fdreshaj/ESP32-Scan-Position-Monitor/README.md

Work in Progress, RF branch for RF. Will be updating with new design
