fdreshaj/ESP32-Scan-Position-Monitor/ESP_32_sens.kicad_pcb

## KiCad design ESP_32_sens.kicad_pcb (2025-09-08)

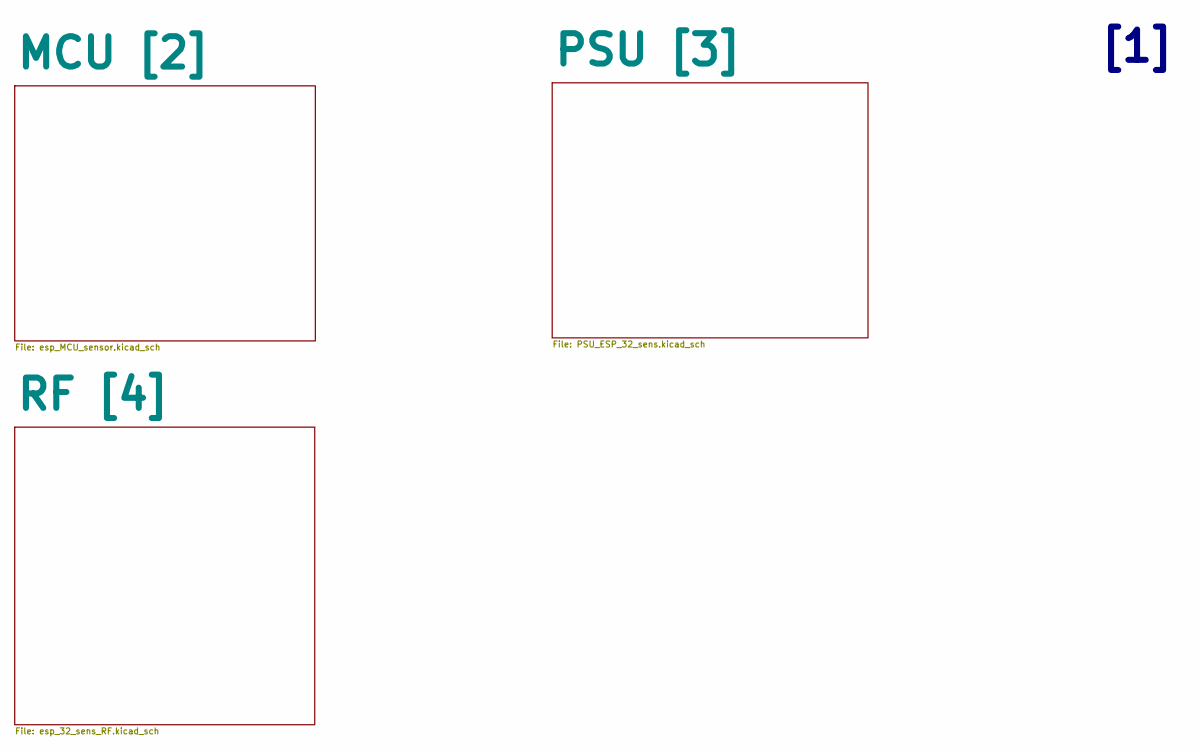
[picture p1: schematic ESP_32_sens.kicad_sch, Motion_Tracker_V0]

Notes on the sheet:
[1]

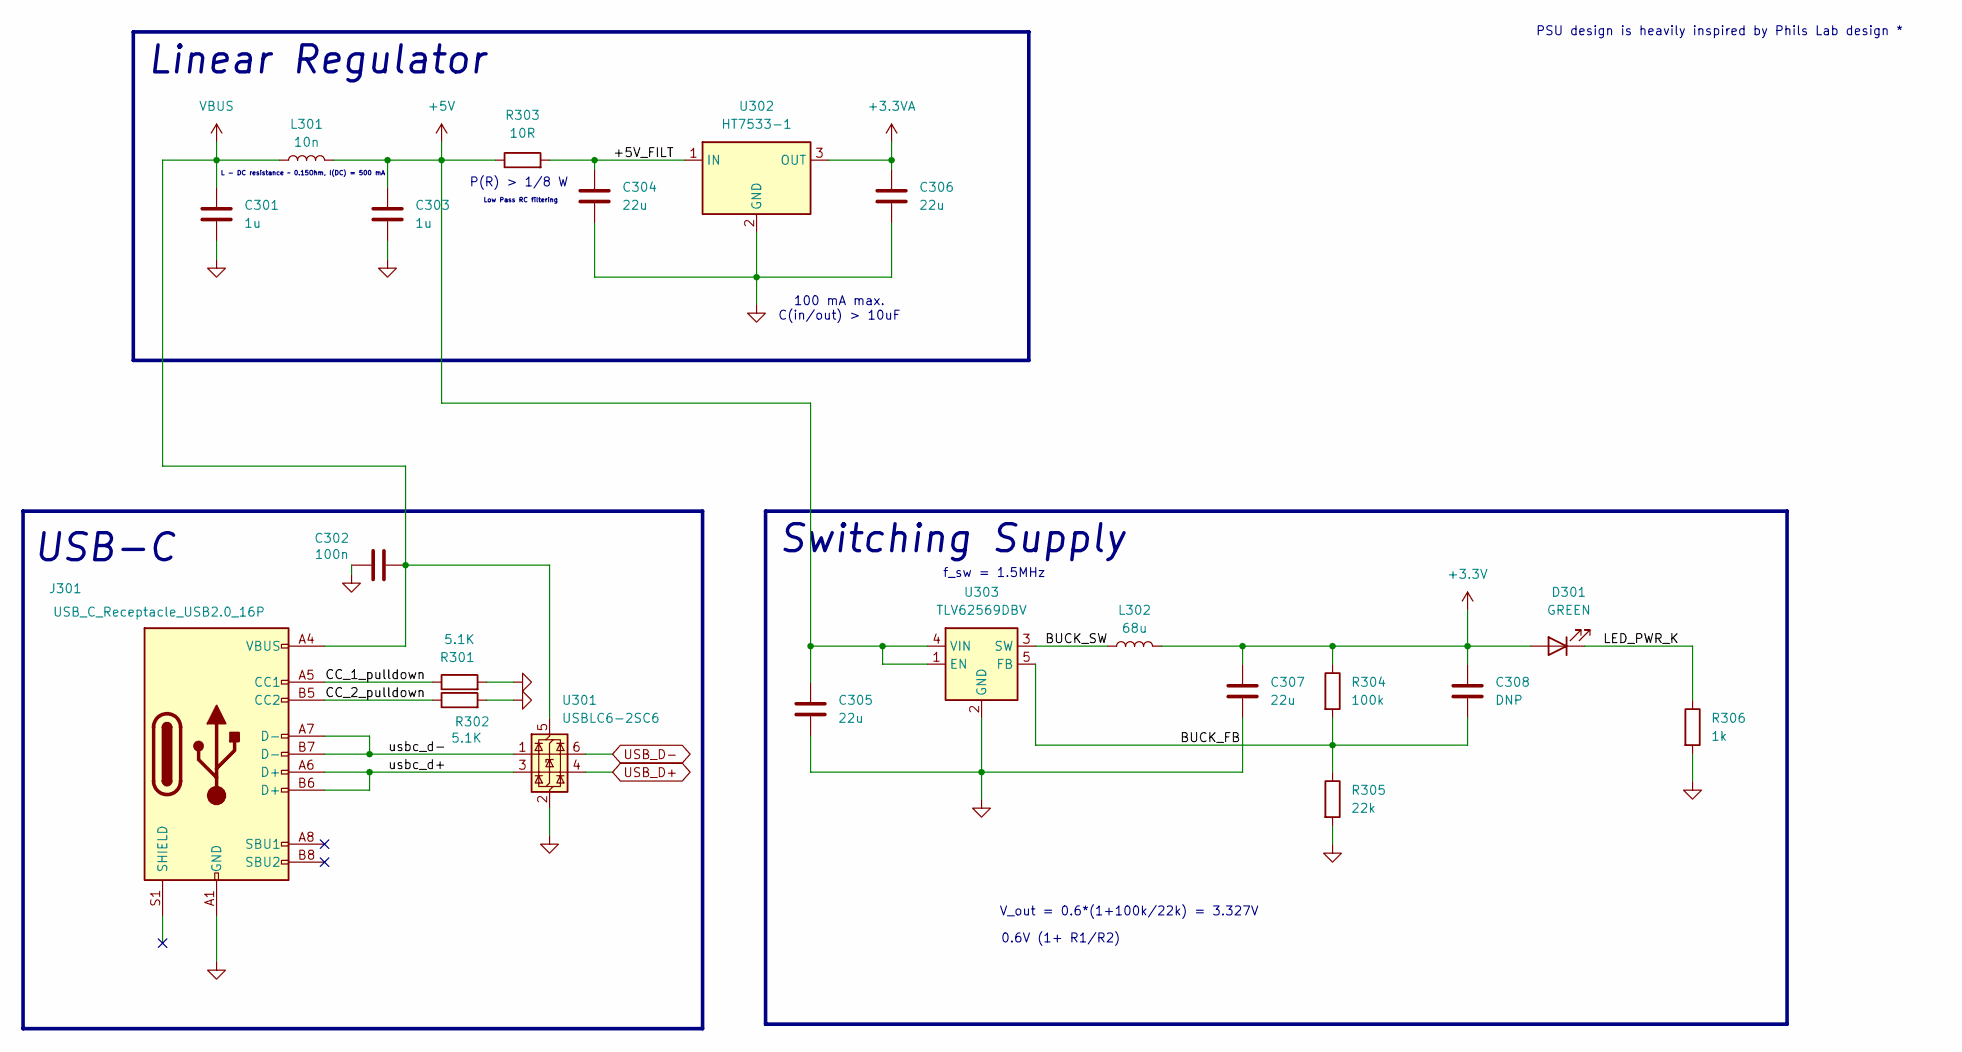
[picture p2: schematic PSU_ESP_32_sens.kicad_sch, Motion_Tracker_V0]

Parts:
C301, C303: 1u; C_0603_1608Metric_Pad1.08x0.95mm_HandSolder
C302: 100n; C_0402_1005Metric_Pad0.74x0.62mm_HandSolder
C304, C305, C306, C307: 22u; C_0603_1608Metric_Pad1.08x0.95mm_HandSolder
C308: DNP; C_0402_1005Metric_Pad0.74x0.62mm_HandSolder
D301: GREEN; LED_0402_1005Metric_Pad0.77x0.64mm_HandSolder
J301: USB_C_Receptacle_USB2.0_16P; USB_C_Receptacle_G-Switch_GT-USB-7010ASV
L301: 10n; L_0402_1005Metric_Pad0.77x0.64mm_HandSolder
L302: 68u; L_0603_1608Metric_Pad1.05x0.95mm_HandSolder
R301, R302: 5.1K; R_0402_1005Metric_Pad0.72x0.64mm_HandSolder
R303: 10R; R_0402_1005Metric_Pad0.72x0.64mm_HandSolder
R304: 100k; R_0402_1005Metric_Pad0.72x0.64mm_HandSolder
R305: 22k; R_0402_1005Metric_Pad0.72x0.64mm_HandSolder
R306: 1k; R_0402_1005Metric_Pad0.72x0.64mm_HandSolder
U301: USBLC6-2SC6; SOT-23-6
U302: HT7533-1; SOT-223-3_TabPin2
U303: TLV62569DBV; SOT-23-5

Connections:
+3.3V: C307.1, C308.1, D301.2 (A), L302.2, R304.1; also elsewhere on the board
+3.3VA: C306.1, U302.3 (OUT); also elsewhere on the board
+5V: C303.1, C305.1, L301.2, R303.1, U303.1 (EN), U303.4 (VIN)
/PSU [3]/+5V_FILT: C304.1, R303.2, U302.1 (IN)
/PSU [3]/BUCK_FB: C308.2, R304.2, R305.1, U303.5 (FB)
/PSU [3]/BUCK_SW: L302.1, U303.3 (SW)
/PSU [3]/CC_1_pulldown: J301.A5 (CC1), R301.1
/PSU [3]/CC_2_pulldown: J301.B5 (CC2), R302.1
/PSU [3]/LED_PWR_K: D301.1 (K), R306.1
/PSU [3]/usbc_d+: J301.A6 (D+), J301.B6 (D+), U301.3 (I/O2)
/PSU [3]/usbc_d-: J301.A7 (D-), J301.B7 (D-), U301.1 (I/O1)
GND: C301.2, C302.1, C303.2, C304.2, C305.2, C306.2, C307.2, J301.A1 (GND), J301.A12 (GND), J301.B1 (GND), J301.B12 (GND), R301.2, R302.2, R305.2, R306.2, U301.2 (GND), U302.2 (GND), U303.2 (GND); also elsewhere on the board
USB_D+: U301.4 (I/O2); also elsewhere on the board
USB_D-: U301.6 (I/O1); also elsewhere on the board
VBUS: C301.1, C302.2, J301.A4 (VBUS), J301.A9 (VBUS), J301.B4 (VBUS), J301.B9 (VBUS), L301.1, U301.5 (VBUS)

Notes on the sheet:
USB-C
Linear Regulator
V_out = 0.6*(1+100k/22k) = 3.327V
Low Pass RC filtering
0.6V (1+ R1/R2)
f_sw = 1.5MHz
Switching Supply
L - DC resistance ~ 0.15Ohm, I(DC) = 500 mA
P(R) > 1/8 W
100 mA max. C(in/out) > 10uF
PSU design is heavily inspired by Phils Lab design *

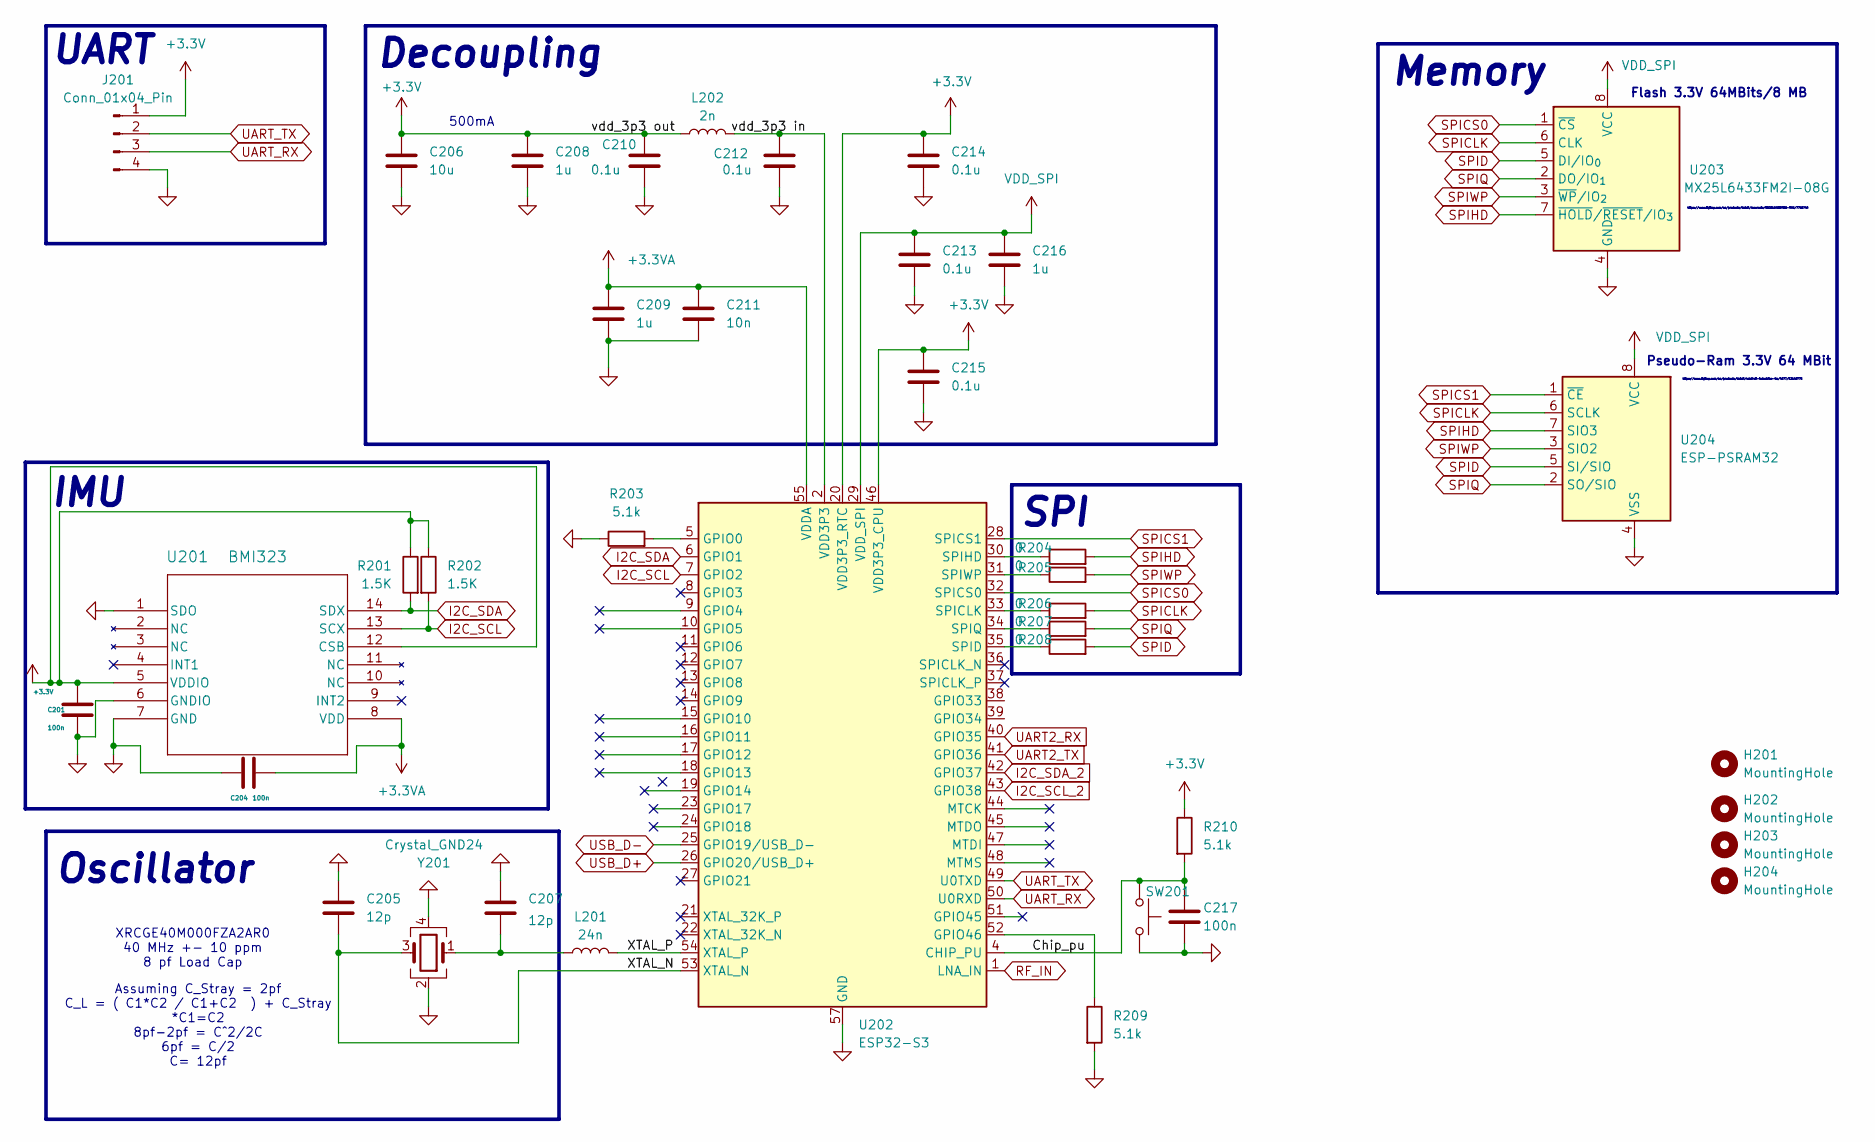
[picture p3: schematic esp_MCU_sensor.kicad_sch, Motion_Tracker_V1]

Parts:
C201, C204, C217: 100n; C_0402_1005Metric_Pad0.74x0.62mm_HandSolder
C205, C207: 12p; C_0402_1005Metric_Pad0.74x0.62mm_HandSolder
C206: 10u; C_0603_1608Metric_Pad1.08x0.95mm_HandSolder
C208, C209, C216: 1u; C_0603_1608Metric_Pad1.08x0.95mm_HandSolder
C210, C212, C213, C214, C215: 0.1u; C_0402_1005Metric_Pad0.74x0.62mm_HandSolder
C211: 10n; C_0402_1005Metric_Pad0.74x0.62mm_HandSolder
H201, H202, H203, H204: MountingHole; MountingHole_3.2mm_M3
J201: Conn_01x04_Pin; Wuerth_WR-WTB_64800411622_1x04_P1.50mm_Vertical
L201: 24n; L_0402_1005Metric_Pad0.77x0.64mm_HandSolder
L202: 2n; L_0402_1005Metric_Pad0.77x0.64mm_HandSolder
R201, R202: 1.5K; R_0402_1005Metric_Pad0.72x0.64mm_HandSolder
R203, R209, R210: 5.1k; R_0402_1005Metric_Pad0.72x0.64mm_HandSolder
R204, R205, R206, R207, R208: 0; R_0402_1005Metric_Pad0.72x0.64mm_HandSolder
SW201: SW_Push; SW_PUSH_6mm_H4.3mm
U201: BMI323; BMI323_BOS
U202: ESP32-S3; QFN-56-1EP_7x7mm_P0.4mm_EP4x4mm
U203: MX25L6433FM2I-08G; SOIC-8_5.3x5.3mm_P1.27mm
U204: ESP-PSRAM32; SOIC-8_3.9x4.9mm_P1.27mm
Y201: Crystal_GND24; Crystal_SMD_SeikoEpson_FA128-4Pin_2.0x1.6mm

Connections:
+3.3V: C201.1, C206.2, C208.2, C210.2, C214.1, C215.1, J201.1, L202.1, R201.1, R202.1, R210.1, U201.5 (VDDIO), U201.12 (CSB), U202.20 (VDD3P3_RTC), U202.46 (VDD3P3_CPU); also elsewhere on the board
+3.3VA: C204.2, C209.1, C211.1, U201.8 (VDD), U202.55 (VDDA), U202.56 (VDDA); also elsewhere on the board
/MCU [2]/Chip_pu: C217.1, R210.2, SW201.1, U202.4 (CHIP_PU)
/MCU [2]/XTAL_N: C205.1, U202.53 (XTAL_N), Y201.3
/MCU [2]/XTAL_P: L201.2, U202.54 (XTAL_P)
/MCU [2]/vdd_3p3 in: C212.2, L202.2, U202.2 (VDD3P3), U202.3 (VDD3P3)
GND: C201.2, C204.1, C205.2, C206.1, C207.2, C208.1, C209.2, C210.1, C211.2, C212.1, C213.2, C214.2, C215.2, C216.2, C217.2, J201.4, R203.1, R209.2, SW201.2, U201.1 (SDO), U201.6 (GNDIO), U201.7 (GND), U202.57 (GND), U203.4 (GND), U204.4 (VSS), Y201.2, Y201.4; also elsewhere on the board
I2C_SCL: R202.2, U201.13 (SCX), U202.7 (GPIO2)
I2C_SCL_2: U202.43 (GPIO38); also elsewhere on the board
I2C_SDA: R201.2, U201.14 (SDX), U202.6 (GPIO1)
I2C_SDA_2: U202.42 (GPIO37); also elsewhere on the board
unnamed: C207.1, L201.1, Y201.1
unnamed: R203.2, U202.5 (GPIO0)
unnamed: R209.1, U202.52 (GPIO46)
unnamed: R206.1, U202.33 (SPICLK)
unnamed: R208.1, U202.35 (SPID)
unnamed: R204.1, U202.30 (SPIHD)
unnamed: R207.1, U202.34 (SPIQ)
unnamed: R205.1, U202.31 (SPIWP)
RF_IN: U202.1 (LNA_IN); also elsewhere on the board
SPICLK: R206.2, U203.6 (CLK), U204.6 (SCLK)
SPICS0: U202.32 (SPICS0), U203.1 (~CS)
SPICS1: U202.28 (SPICS1), U204.1 (~CE)
SPID: R208.2, U203.5 (DI/IO_{0}), U204.5 (SI/SIO)
SPIHD: R204.2, U203.7 (~HOLD/~RESET/IO_{3}), U204.7 (SIO3)
SPIQ: R207.2, U203.2 (DO/IO_{1}), U204.2 (SO/SIO)
SPIWP: R205.2, U203.3 (~WP/IO_{2}), U204.3 (SIO2)
UART2_RX: U202.40 (GPIO35); also elsewhere on the board
UART2_TX: U202.41 (GPIO36); also elsewhere on the board
UART_RX: J201.3, U202.50 (U0RXD)
UART_TX: J201.2, U202.49 (U0TXD)
USB_D+: U202.26 (GPIO20/USB_D+); also elsewhere on the board
USB_D-: U202.25 (GPIO19/USB_D-); also elsewhere on the board
VDD_SPI: C213.1, C216.1, U202.29 (VDD_SPI), U203.8 (VCC), U204.8 (VCC)

Notes on the sheet:
SPI
IMU
Memory
Decoupling
UART
XRCGE40M000FZA2AR0 40 MHz +- 10 ppm 8 pf Load Cap
https://www.digikey.com/en/products/detail/adafruit-industries-llc/4677/13148775
Flash 3.3V 64MBits/8 MB
https://www.digikey.com/en/products/detail/macronix/MX25L6433FM2I-08G/7796740
500mA
Assuming C_Stray = 2pf C_L = ( C1*C2 / C1+C2 ) + C_Stray *C1=C2 8pf-2pf = C^2/2C 6pf = C/2 C= 12pf
Pseudo-Ram 3.3V 64 MBit
Oscillator

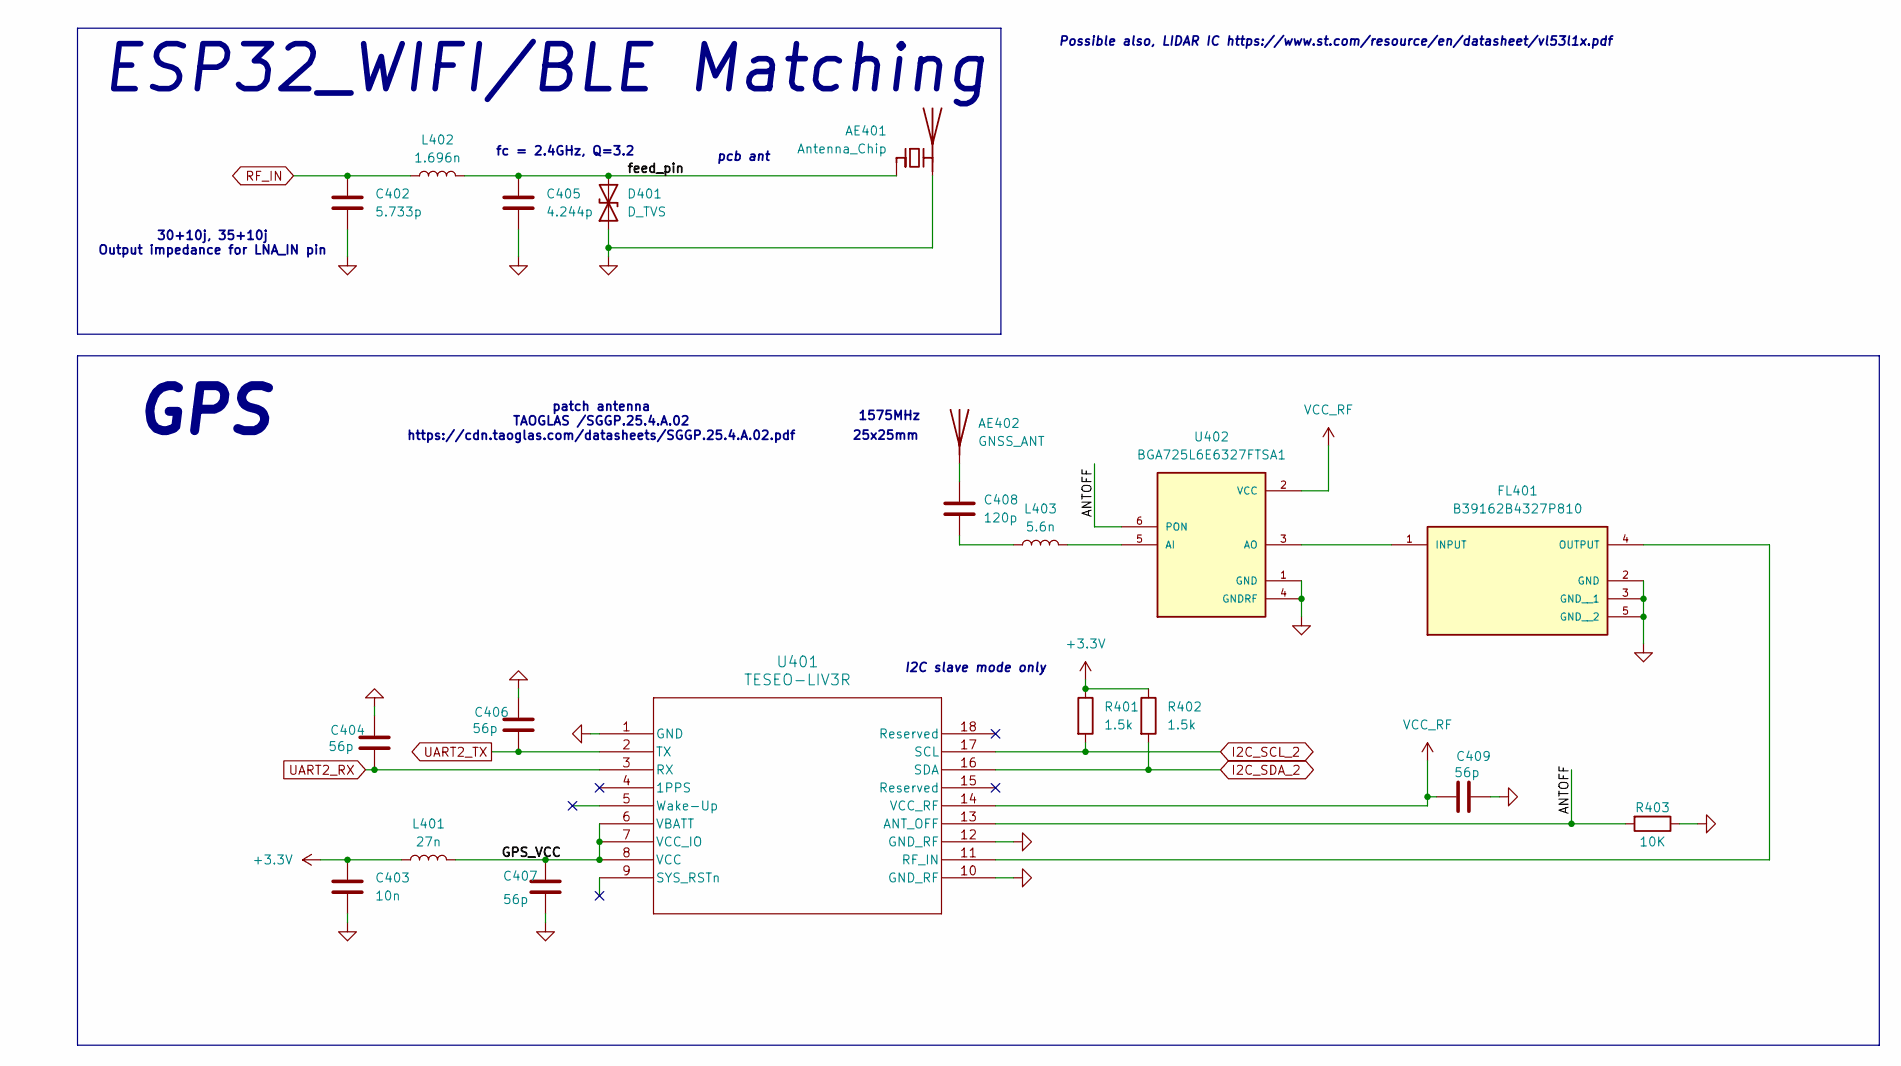
[picture p4: schematic esp_32_sens_RF.kicad_sch]

Parts:
AE401: Antenna_Chip; IFA_2.45_TI
AE402: GNSS_ANT; SGGP.25.4.A.02_TAL
C402: 5.733p; C_0201_0603Metric_Pad0.64x0.40mm_HandSolder
C403: 10n; C_0402_1005Metric_Pad0.74x0.62mm_HandSolder
C404, C406, C407, C409: 56p; C_0402_1005Metric_Pad0.74x0.62mm_HandSolder
C405: 4.244p; C_0201_0603Metric_Pad0.64x0.40mm_HandSolder
C408: 120p; C_0402_1005Metric_Pad0.74x0.62mm_HandSolder
D401: D_TVS; D_0402_1005Metric_Pad0.77x0.64mm_HandSolder
FL401: B39162B4327P810; FIL_B39162B4327P810; PARTREV October 25, 2019
L401: 27n; L_0402_1005Metric_Pad0.77x0.64mm_HandSolder
L402: 1.696n; L_0201_0603Metric_Pad0.64x0.40mm_HandSolder
L403: 5.6n; L_0402_1005Metric_Pad0.77x0.64mm_HandSolder
R401, R402: 1.5k; R_0402_1005Metric_Pad0.72x0.64mm_HandSolder
R403: 10K; R_0402_1005Metric_Pad0.72x0.64mm_HandSolder
U401: TESEO-LIV3R; ARRAY_LIV3R_STM
U402: BGA725L6E6327FTSA1; AMP_BGA725L6E6327FTSA1; PARTREV 2.0

Connections:
+3.3V: C403.1, L401.1, R401.1, R402.1; also elsewhere on the board
/RF [4]/ANTOFF: R403.2, U401.13 (ANT_OFF), U402.6 (PON)
/RF [4]/GPS_VCC: C407.1, L401.2, U401.6 (VBATT), U401.7 (VCC_IO), U401.8 (VCC)
/RF [4]/feed_pin: AE401.1 (FEED), C405.1, D401.2 (A2), L402.2
GND: AE401.2 (PCB_Trace), C402.2, C403.2, C404.1, C405.2, C406.1, C407.2, C409.1, D401.1 (A1), FL401.2 (GND), FL401.3 (GND__1), FL401.5 (GND__2), R403.1, U401.1 (GND), U401.10 (GND_RF), U401.12 (GND_RF), U402.1 (GND), U402.4 (GNDRF); also elsewhere on the board
I2C_SCL_2: R401.2, U401.17 (SCL); also elsewhere on the board
I2C_SDA_2: R402.2, U401.16 (SDA); also elsewhere on the board
unnamed: AE402.1 (A), C408.1
unnamed: C408.2, L403.1
unnamed: FL401.1 (INPUT), U402.3 (AO)
unnamed: FL401.4 (OUTPUT), U401.11 (RF_IN)
unnamed: L403.2, U402.5 (AI)
RF_IN: C402.1, L402.1; also elsewhere on the board
UART2_RX: C404.2, U401.3 (RX); also elsewhere on the board
UART2_TX: C406.2, U401.2 (TX); also elsewhere on the board
VCC_RF: C409.2, U401.14 (VCC_RF), U402.2 (VCC)

Notes on the sheet:
GPS
I2C slave mode only
pcb ant
Possible also, LIDAR IC https://www.st.com/resource/en/datasheet/vl53l1x.pdf
25x25mm
patch antenna TAOGLAS /SGGP.25.4.A.02 https://cdn.taoglas.com/datasheets/SGGP.25.4.A.02.pdf
30+10j, 35+10j Output impedance for LNA_IN pin
ESP32_WIFI/BLE Matching
fc = 2.4GHz, Q=3.2
1575MHz

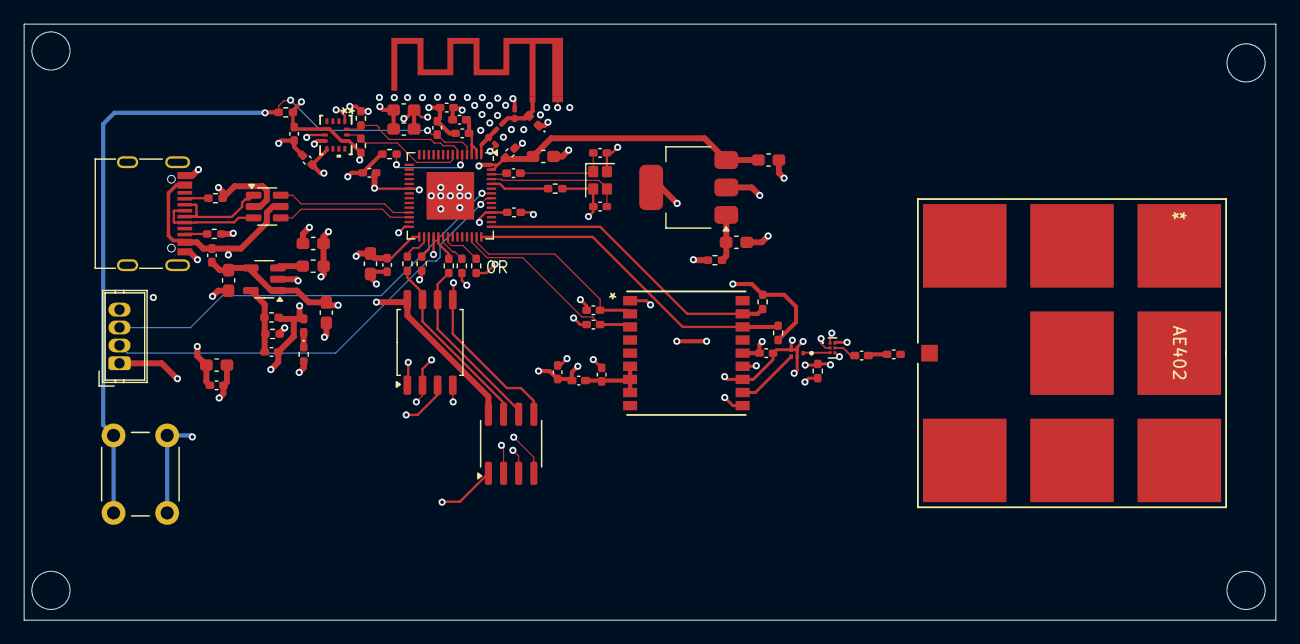
[picture p5: board ESP_32_sens.kicad_pcb from above]

Board: 4 copper layers, 105.0 x 50.0 mm, 79 parts (0 on the bottom side), 53 nets.
