fdreshaj/ESP32-Scan-Position-Monitor/(commit log)

2025-08-14 sent to folder grb
    sent to folder grb
    [ESP_32_sens-B_Cu.gbr, ESP_32_sens-B_Mask.gbr, ESP_32_sens-B_Paste.gbr, ESP_32_sens-B_Silkscreen.gbr, ESP_32_sens-Edge_Cuts.gbr, ESP_32_sens-F_Cu.gbr, ESP_32_sens-F_Mask.gbr, ESP_32_sens-F_Paste.gbr]
2025-08-15 more correct ground plane
    ground plane
    [ESP_32_sens-B_Cu.gbr, ESP_32_sens-B_Mask.gbr, ESP_32_sens-B_Paste.gbr, ESP_32_sens-B_Silkscreen.gbr, ESP_32_sens-Edge_Cuts.gbr, ESP_32_sens-F_Cu.gbr, ESP_32_sens-F_Mask.gbr, ESP_32_sens-F_Paste.gbr]
2025-08-15 additional comment
    additional comment
    [PSU_ESP_32_sens.kicad_sch]
2025-08-18 Add RF schematics for GPS + designed Pi filter for imp matching
    added impedance matching on LNA 1 pin, added GPS/GNSS IC
    [ESP_32_sens.kicad_sch, esp_32_sens_RF.kicad_sch, esp_MCU_sensor.kicad_sch]
2025-08-18 Added antenna design
    added pcb antenna design
    [ESP_32_sens.kicad_pcb, esp_MCU_sensor.kicad_sch]
2025-08-19 placement done
    placement done, routing left
    [ESP_32_sens.kicad_pcb, ESP_32_sens.kicad_sch, PSU_ESP_32_sens.kicad_sch, esp_32_sens_RF.kicad_sch, esp_MCU_sensor.kicad_sch]
2025-08-21 added via stichitching and routing,
    routing mostly done, Only power left
    [ESP_32_sens.kicad_pcb]
2025-08-22 finished power routing
    finished power routing, gps antenna left
    [ESP_32_sens.kicad_pcb, esp_MCU_sensor.kicad_sch]
2025-08-22 minor changes
    minor changes
    [ESP_32_sens.kicad_pcb, esp_MCU_sensor.kicad_sch]
